killer-snow/psy4ysh-legocam/README.md

# 📷 Psy4ysh LegoCam — ESP32-CAM DIY DigiCam







<p align="center">
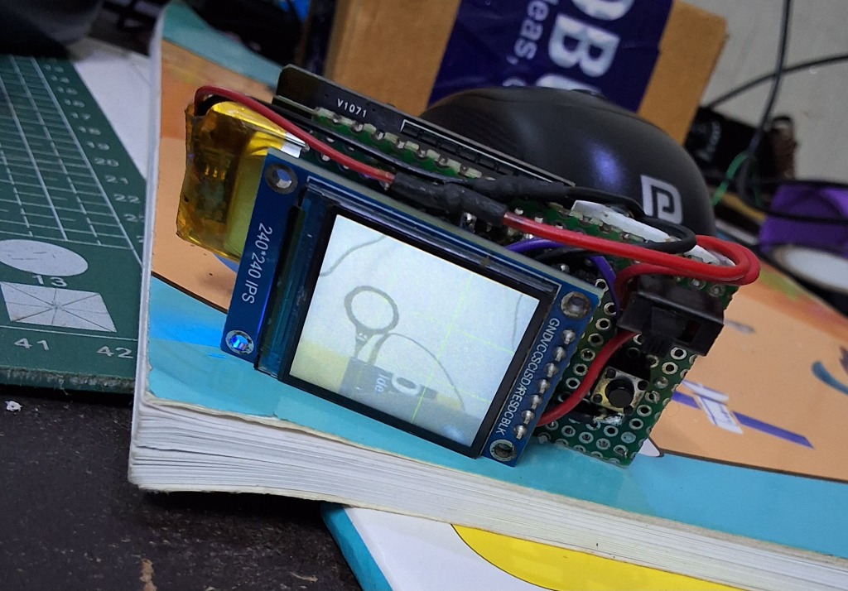
[picture p1: assets/feature.jpg]
Psy4ysh LegoCam Hardware Prototype
  
</p>

A compact, standalone, retro-style digital camera built with an **AI-Thinker ESP32-CAM**, a **1.3" 240x240 IPS ST7789 display**, and a tactile shutter push-button. 

Designed for custom enclosures (like a 3D-printed or Lego camera chassis), it features a real-time viewfinder on the physical screen and a companion **Wi-Fi Access Point** that automatically beams full-resolution **UXGA (1600x1200)** photos directly to your smartphone or laptop browser — with zero cloud, zero apps, and zero internet connection required.

---

## ✨ Features

- **Live IPS Viewfinder**: Real-time camera feed rendered onto a 1.3" 240x240 ST7789 IPS display with a composition **Rule-of-Thirds grid** and blinking recording indicator.
- **Dual-Resolution Architecture**:
  - Standby Viewfinder: Smooth **QVGA (320x240)** stream centered on the square screen for maximum frame rate.
  - Shutter Trigger: Dynamically switches the OV2640 ISP to **UXGA (1600x1200)** high quality (`jpeg_quality = 10`) for maximum resolution with frame validation.
- **Thread-Safe Triple-Buffered PSRAM Pool**:
  - Zero heap fragmentation: 3 pre-allocated fixed slots in PSRAM eliminate dynamic `ps_malloc` / `free` during runtime.
  - Reference-counted reader lock prevents use-after-free and crash conditions between the FreeRTOS HTTP task and the shutter.
  - Instant shutter re-triggering with zero shutter lag.
- **Responsive Non-Blocking State Machine**:
  - 2.5-second photo review on LCD with background DNS pump (eliminates captive portal timeouts).
  - Tapping shutter during preview immediately snaps the next shot.
- **Wi-Fi Companion Studio (SoftAP)**:
  - Creates a local Wi-Fi hotspot (`DigiCam-AP`).
  - Webpage hosted directly at `http://192.168.4.1/` (or `http://digicam.local/`).
  - **Auto-Fetch & Download**: Automatically fetches captured photos and provides direct JPG file download. A native "Share" button appears conditionally if the browser exposes the Web Share API in the active context.
- **Hardware-Tuned ISP Pipeline**:
  - Hardware noise reduction filter (`denoise = 1`).
  - Edge sharpening (`sharpness = 2`).
  - Capped analog gain (`gainceiling = 3`) to eliminate chromatic salt-and-pepper noise in low light.
  - Lens shading correction (`lenc`), black pixel correction (`bpc`), and gamma curve correction (`raw_gma`).
- **Power & Heat Optimized**:
  - No continuous video streaming over Wi-Fi, preserving battery life and keeping the ESP32-CAM cool.
  - Maximum RF transmit power configured (`19.5 dBm`) for reliable range.

---

## 📐 Circuit & Wiring Pinout

<p align="center">
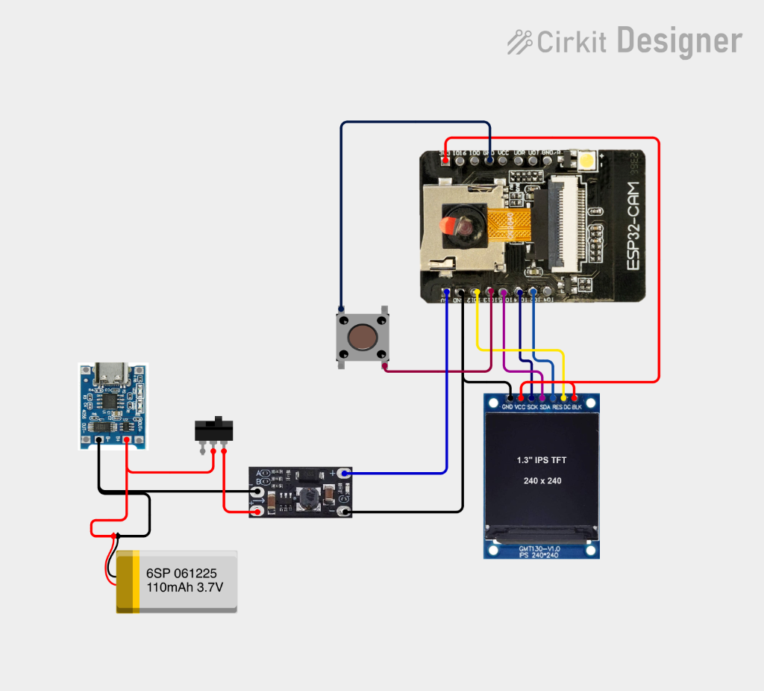
[picture p2: assets/circuit.png]
Complete Circuit Schematic
  
</p>

### 1. Power Supply & Battery Management Circuit
| Module / Part | Connections | Purpose |
| :--- | :--- | :--- |
| **3.7V LiPo Battery (110mAh)** | `B+` / `B-` -> TP4056 `B+` / `B-` | Power source (6SP 061225) |
| **TP4056 USB-C Charger** | `OUT-` -> Common GND<br>`OUT+` -> Power Switch | Battery charging & over-discharge protection |
| **Slide Switch (SPDT)** | Between TP4056 `OUT+` and Boost Converter `IN+` | Hardware power ON/OFF switch |
| **Step-Up Boost Converter** | `IN+` -> Switch<br>`IN-` -> GND<br>`OUT+` -> ESP32-CAM `5V`<br>`OUT-` -> GND | Boosts 3.7V battery voltage to stable **5.0V** to eliminate brownouts |

> [!CAUTION]
> **Battery Sizing & TP4056 Safety Warning:**
> - Standard TP4056 modules come pre-configured with a 1.2kΩ resistor (`R3`/`Rprog`), which charges cells at **1,000mA (1A)**.
> - Charging a 110mAh LiPo cell at 1,000mA is a **9C charge rate** and is an extreme **fire/thermal hazard**!
> - **Recommendation**: Upgrade the battery to an **800mAh–1200mAh 1S LiPo** (e.g. 803040 or 103450 pouch cell) or an 18650 cell. This safely absorbs 1A charging and extends battery runtime from ~15 minutes to **2–3 hours** of continuous photography. If you must use a small 110mAh cell, you MUST swap `Rprog` on the TP4056 board to a **≥12kΩ** resistor (12kΩ ≈ 100mA, 20kΩ ≈ 60mA) to keep the charge rate at or below 1C.

### 2. ST7789 7-Pin SPI IPS Display (240x240)
| ST7789 Pin | ESP32-CAM Pin | Description |
| :--- | :--- | :--- |
| **VCC** | **3V3** | 3.3V Power |
| **GND** | **GND** | System Ground |
| **SCL / CLK** | **GPIO 14** | SPI Clock (HSPI SCLK) |
| **SDA / MOSI**| **GPIO 15** | SPI Data (HSPI MOSI) |
| **RES / RST** | **GPIO 2** | Hardware Reset |
| **DC** | **GPIO 12** | Data / Command Selection |
| **BLK / LED** | **3V3** | Backlight (tie to 3V3 for full brightness) |
| **CS** | *N/A* | 7-pin modules have CS internally tied to GND |

### 3. Shutter Button & Flash
| Component | ESP32-CAM Pin | Wiring Details |
| :--- | :--- | :--- |
| **Shutter Button** | **GPIO 13** | Momentary push-button connected between **GPIO 13** and **GND** (uses internal `INPUT_PULLUP`). |
| **Onboard Flash** | **GPIO 4** | Controlled via software; kept LOW to prevent unwanted glowing. |

> [!NOTE]
> All used GPIOs (`12, 13, 14, 15, 2`) are broken out on the ESP32-CAM header and do not collide with the OV2640 camera bus or the 8MB external PSRAM (`GPIO 16/17`).

---

## 🖨️ 3D Printable Camera Enclosure (`cam_body/`)

<p align="center">
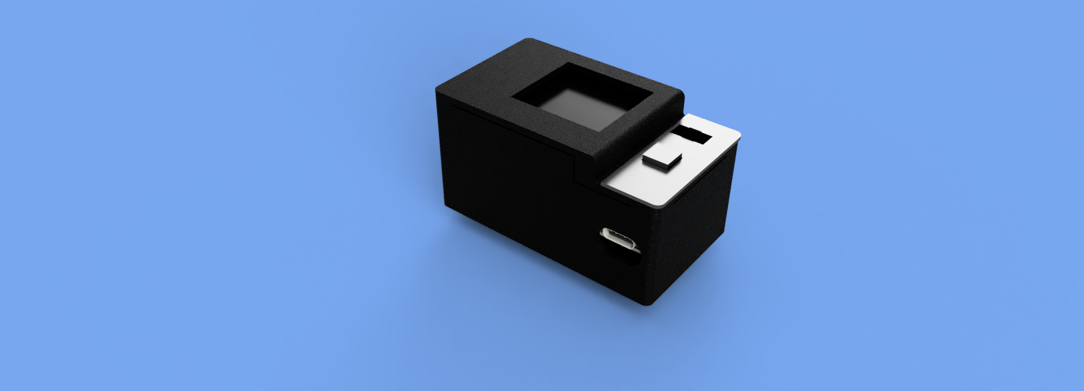
[picture p3: cam_body/espcam shoot.PNG]
3D Printable Camera Enclosure Render
  
</p>

The repository includes ready-to-print **STL 3D models** located in the [`cam_body/`](cam_body/) directory, specifically tailored to house the ESP32-CAM, ST7789 display, TP4056 USB-C charging module, battery, boost converter, and switches:

| File | Description |
| :--- | :--- |
| [`espcam bod.stl`](cam_body/espcam%20bod.stl) | Main chassis body with cutouts for ST7789 screen, lens, and side USB-C charging port |
| [`espcam  cover.stl`](cam_body/espcam%20%20cover.stl) | Protective enclosure cover plate |
| [`cam button.stl`](cam_body/cam%20button.stl) | Ergonomic shutter button cap |
| [`switch plate.stl`](cam_body/switch%20plate.stl) | Mounting plate for the slide power switch and tactile button |

---

## 🛠️ Software Setup & Installation

### 1. Required Arduino Libraries
Install the following libraries via the Arduino IDE Library Manager (**Sketch > Include Library > Manage Libraries...**):
1. **`TFT_eSPI`** by Bodmer
2. **`TJpg_Decoder`** by Bodmer

### 2. Configuring `TFT_eSPI`
Because `TFT_eSPI` supports dozens of display chips and pinouts, you must point it to the included custom setup file:

1. Copy the included [`User_Setup_digicam.h`](User_Setup_digicam.h) into your Arduino library folder:
   ```text
   Documents/Arduino/libraries/TFT_eSPI/User_Setup_digicam.h
   ```
2. Open `Documents/Arduino/libraries/TFT_eSPI/User_Setup_Select.h`:
   - Uncomment line 29:
     ```cpp
     #include <User_Setup_digicam.h>
     ```
   - Make sure all other setup files (including `Setup24_ST7789.h` or default `User_Setup.h`) are **commented out**.

---

## 💻 Arduino IDE Board Settings

In the Arduino IDE menu under **Tools**, apply these exact settings:

| Setting | Recommended Value | Why? |
| :--- | :--- | :--- |
| **Board** | `AI Thinker ESP32-CAM` | Matches camera pinout & clock configurations |
| **CPU Frequency** | `240MHz (WiFi/BT)` | Maximum processing speed for JPEG rendering |
| **Flash Frequency**| `80MHz` | Fast SPI flash access |
| **Flash Mode** | `QIO` | Quad I/O speed |
| **Partition Scheme** | `Huge APP (3MB No OTA/1MB SPIFFS)` | **Crucial:** Standard partition is too small for WebServer + Camera + Display code |
| **PSRAM** | **`Enabled`** | **Crucial:** Required to allocate high-resolution 1600x1200 frame buffers |
| **Upload Speed** | `115200` or `921600` | Standard serial flashing baud rate |

---

## ⚡ Flashing the ESP32-CAM

1. Connect an FTDI USB-to-TTL programmer to the ESP32-CAM:
   - FTDI `VCC (5V)` -> ESP32-CAM `5V`
   - FTDI `GND` -> ESP32-CAM `GND`
   - FTDI `TX` -> ESP32-CAM `U0R (GPIO 3)`
   - FTDI `RX` -> ESP32-CAM `U0T (GPIO 1)`
2. **Bootloader Mode**: Connect a jumper wire between **GPIO 0 and GND**, then press the **RST** button.
3. Click **Upload** in the Arduino IDE.
4. **Run Mode**: Once the upload reaches 100%, **disconnect GPIO 0 from GND**, and press the **RST** button again to start the camera.

---

## 🚀 How to Use

1. **Power On**:
   - Power the camera via the 5V pin using a battery pack or step-up booster.
   - The ST7789 screen turns on immediately and presents the live viewfinder with rule-of-thirds composition aids.
2. **Shooting a Photo**:
   - Aim your subject and press the shutter button on **GPIO 13**.
   - The camera switches to UXGA, takes a full 1600x1200 shot, and displays a 3-second preview of the photo on the LCD before returning to the live viewfinder.
3. **Downloading Photos Wirelessly**:
   - On your smartphone, tablet, or laptop, connect to the Wi-Fi network:
     - **SSID**: `DigiCam-AP`
     - **Password**: `123456789`
   - Open your browser and navigate to:
     ```text
     http://192.168.4.1/
     ```
   - When you press the physical shutter button, the photo automatically streams to the page and downloads to your device! A manual **DOWNLOAD PHOTO** button is also available.

---

## 🔍 Getting Maximum Image Quality (Hardware Focus Trick)

If your photos look blurry or soft out of the box, perform these two physical adjustments:

1. **Peel Off the Lens Film**: Check the tiny glass lens. Brand new OV2640 modules often ship with a small, nearly invisible protective film that causes a milky, hazy look. Peel it off.
2. **Adjust the Manual Focus Ring**:
   - Most factory OV2640 lenses are glued or adjusted for macro distance (10–15 cm).
   - Point your camera at an object across the room (1–3 meters away).
   - Gently twist the outer brass ring of the lens counter-clockwise by half a turn to one full turn while watching the ST7789 screen.
   - You will see the image snap from blurry to razor-sharp!

---

## 📂 Project File Structure

```text
ESP32_DigiCam/
├── assets/
│   ├── feature.jpg         # Prototype hardware hero photo
│   └── circuit.png         # Full Cirkit Designer wiring schematic
├── cam_body/               # 3D printable camera enclosure (.stl models & render)
│   ├── cam button.stl      # Shutter button cap
│   ├── espcam  cover.stl   # Enclosure cover plate
│   ├── espcam bod.stl      # Main camera body chassis
│   ├── espcam shoot.PNG    # 3D enclosure preview render
│   └── switch plate.stl    # Power switch plate
├── ESP32_DigiCam.ino       # Core firmware: camera driver, ST7789 engine, HTTP server & state machine
├── camera_pins.h           # Hardware pin definitions for AI-Thinker ESP32-CAM
├── web_page.h              # Embedded companion web application (PROGMEM HTML/CSS/JS)
├── User_Setup_digicam.h    # Preconfigured TFT_eSPI driver file for 7-pin ST7789
└── README.md               # Complete project documentation & hardware guide
```

---

## 🤝 Credits & Acknowledgments

- [Espressif](https://github.com/espressif/esp32-camera) for the official `esp32-camera` driver.
- [Bodmer](https://github.com/Bodmer) for the high-performance [`TFT_eSPI`](https://github.com/Bodmer/TFT_eSPI) and [`TJpg_Decoder`](https://github.com/Bodmer/TJpg_Decoder) libraries.
- Inspired by the open-source ESP32 camera maker community.

---

## 📄 License
This project is open-source and available under the [MIT License](LICENSE). Feel free to modify, build your own Lego enclosures, and share!
