killer-snow/psy4ysh-legocam/cam_body/switch plate.stl

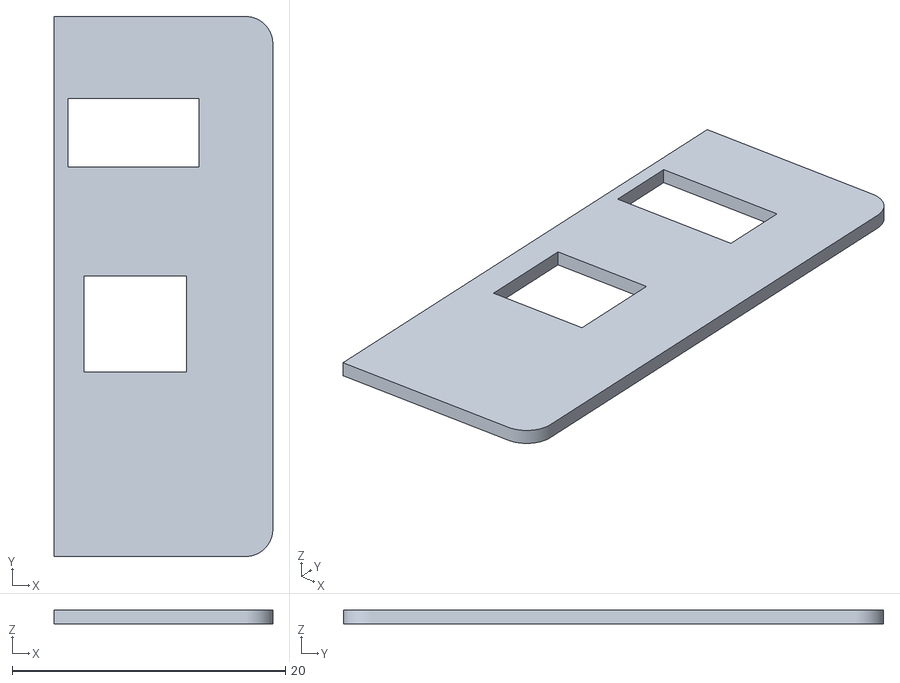
[picture p4: CAD file, 2026-10-13]
cam_body/switch plate.stl
16.0 x 39.5 x 1.00
