killer-snow/psy4ysh-legocam/cam_body/espcam  cover.stl

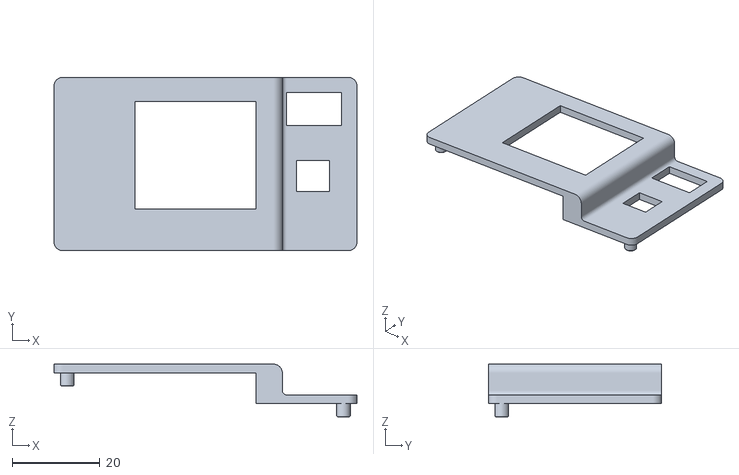
[picture p5: CAD file, 2026-10-13]
cam_body/espcam cover.stl
69.0 x 39.5 x 12.0
