killer-snow/psy4ysh-legocam/cam_body/espcam bod.stl

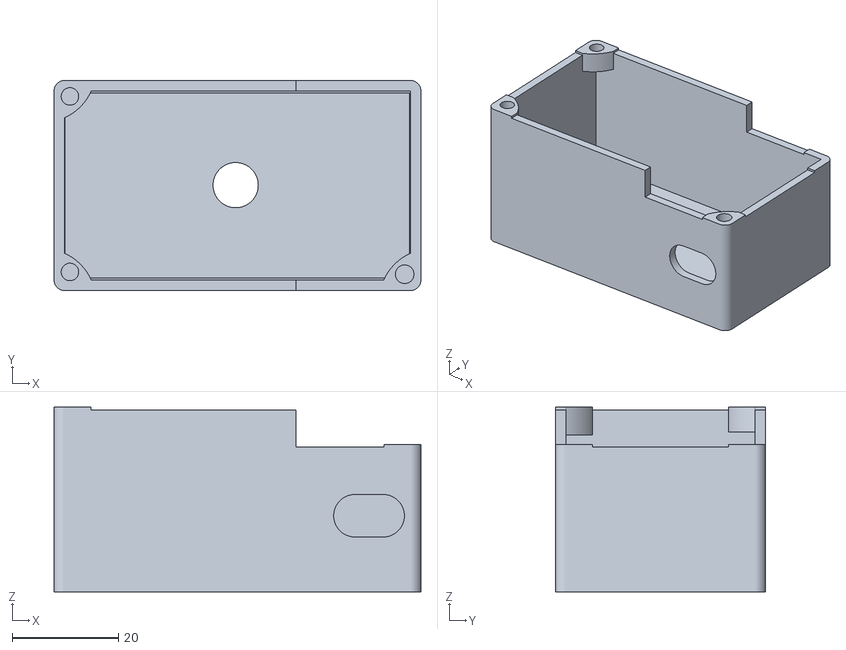
[picture p6: CAD file, 2026-10-13]
cam_body/espcam bod.stl
69.0 x 39.5 x 34.7
