killer-snow/psy4ysh-legocam/cam_body/cam button.stl

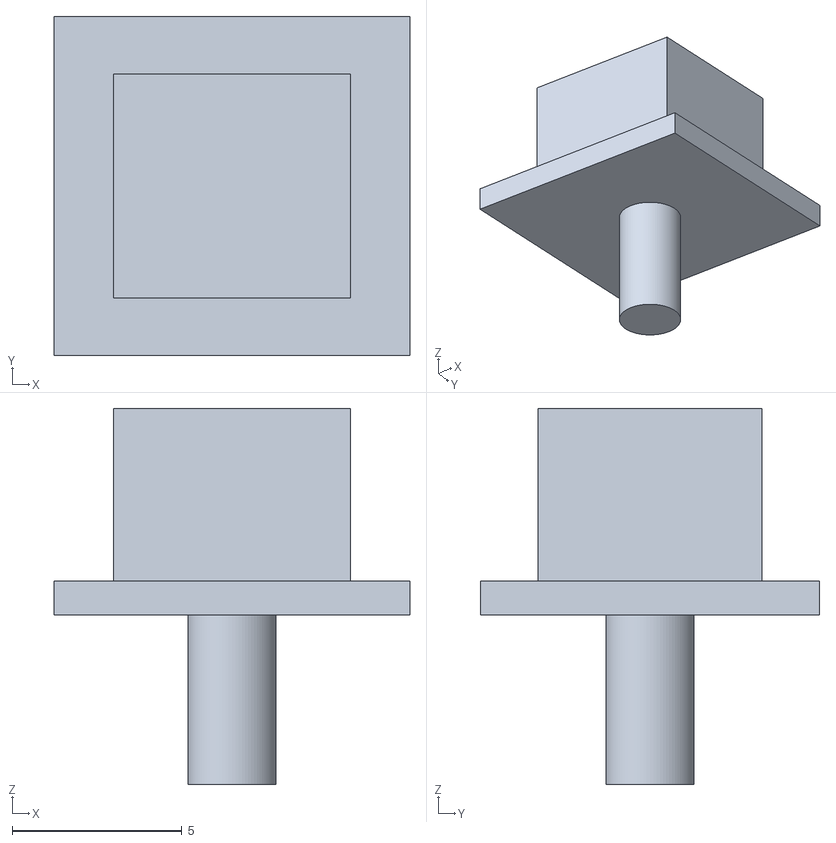
[picture p7: CAD file, 2026-10-13]
cam_body/cam button.stl
10.5 x 10.0 x 11.1
