killer-snow/psy4ysh-legocam/(commit log)

2026-09-16 feat(hardware): define pin mapping for AI-Thinker ESP32-CAM and ST7789 display
2026-09-16 feat(web): add companion web app for wireless photo transfer and auto-download
2026-09-16 feat(firmware): implement core camera engine and ST7789 live viewfinder
2026-09-16 docs: add comprehensive hardware guide, wiring schematic, and setup instructions
2026-09-16 docs: add hero prototype image, circuit schematic, and battery circuit details
2026-09-23 feat(network): add offline captive portal DNS and web server socket optimization
2026-10-13 feat(3d-print): add 3D printable camera enclosure STL models and CAD render
2026-10-17 fix(firmware): harden concurrency, psram buffer pool, and network streaming
    - Replace dynamic ps_malloc allocation with pre-allocated 3-slot PSRAM pool.
    - Add reference-counted reader locks to prevent race conditions during shutter capture.
    - Switch to RFC 9112 compliant full-body HTTP image streaming with X-Photo-Id header.
    - Fix tft_output clipping logic to prevent premature raster decoding aborts.
    - Refactor viewfinder and review sequence into non-blocking state machine with continuous DNS pumping.
    - Configure static SoftAP DHCP parameters and enable mDNS responder.
    - Add request and body timeouts and full polling lifecycle guards to companion web page.
    - Mirror transfer progress and erro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
