killer-snow/psy4ysh-legocam/(notices)

Notices in the files:
README.md:
License: MIT
